femtoduino/femu-hardware/femu/femu-1.0.3.b_2-LAYER-BOTTOM.png

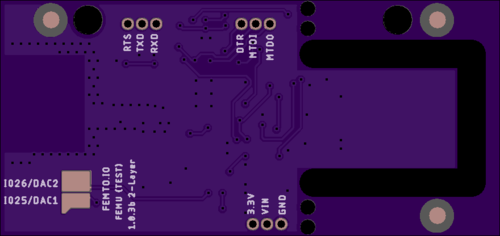
femu/femu-1.0.3.b_2-LAYER-BOTTOM.png
