femtoduino/femu-hardware/femu/femu-1.0.3.b_2-LAYER-TOP.png

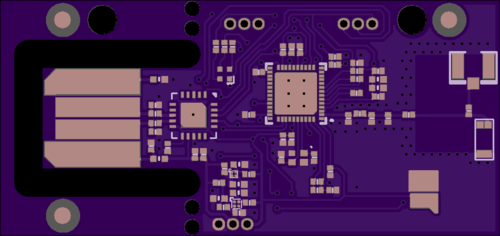
femu/femu-1.0.3.b_2-LAYER-TOP.png
