femtoduino/femu-hardware/femu/kicad/femu/femu-bottom.png

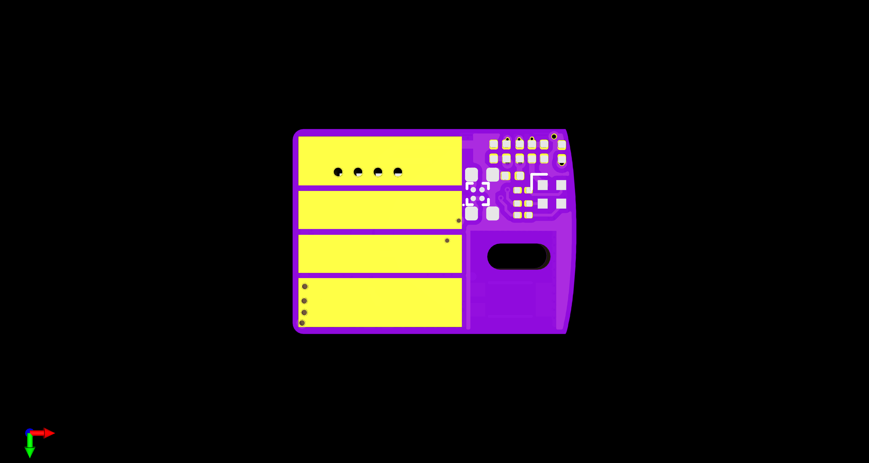
femu/kicad/femu/femu-bottom.png
