femtoduino/femu-hardware/3d-models/femu-2layer-wedge-Cube_001.stl

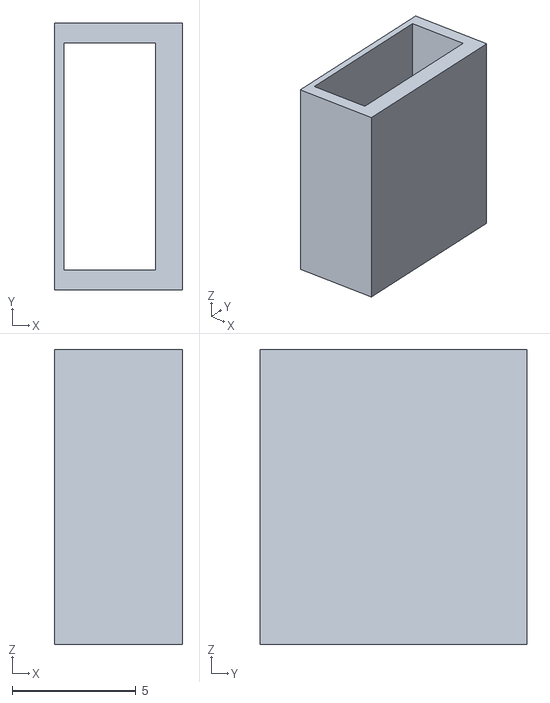
[picture p4: CAD file, 2019-12-23]
3d-models/femu-2layer-wedge-Cube_001.stl
5.20 x 10.8 x 11.9
