femtoduino/femu-hardware/3d-models/femu-2layer-1.0.3-jig-Cube.stl

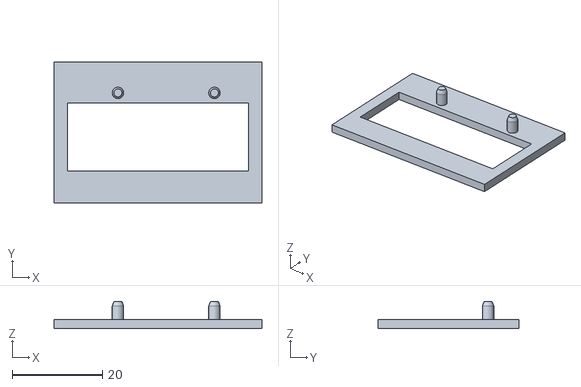
[picture p5: CAD file, 2019-12-23]
3d-models/femu-2layer-1.0.3-jig-Cube.stl
46.0 x 31.1 x 6.00
