femtoduino/femu-hardware/3d-models/femu-stencil-jig.stl

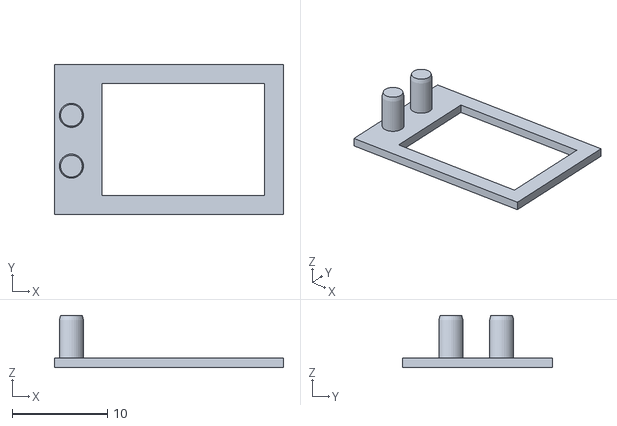
[picture p6: CAD file, 2019-08-23]
3d-models/femu-stencil-jig.stl
24.1 x 15.8 x 5.50
