femtoduino/femu-hardware/(list of files, cad)

Other CAD files:
3d-models/femu-2layer-1.0.3-jig.blend
3d-models/femu-2layer-wedge.blend
3d-models/femu-stencil-jig.blend
