femtoduino/femu-hardware/femu/femu-1.0.2-parts01005-schematic.pdf

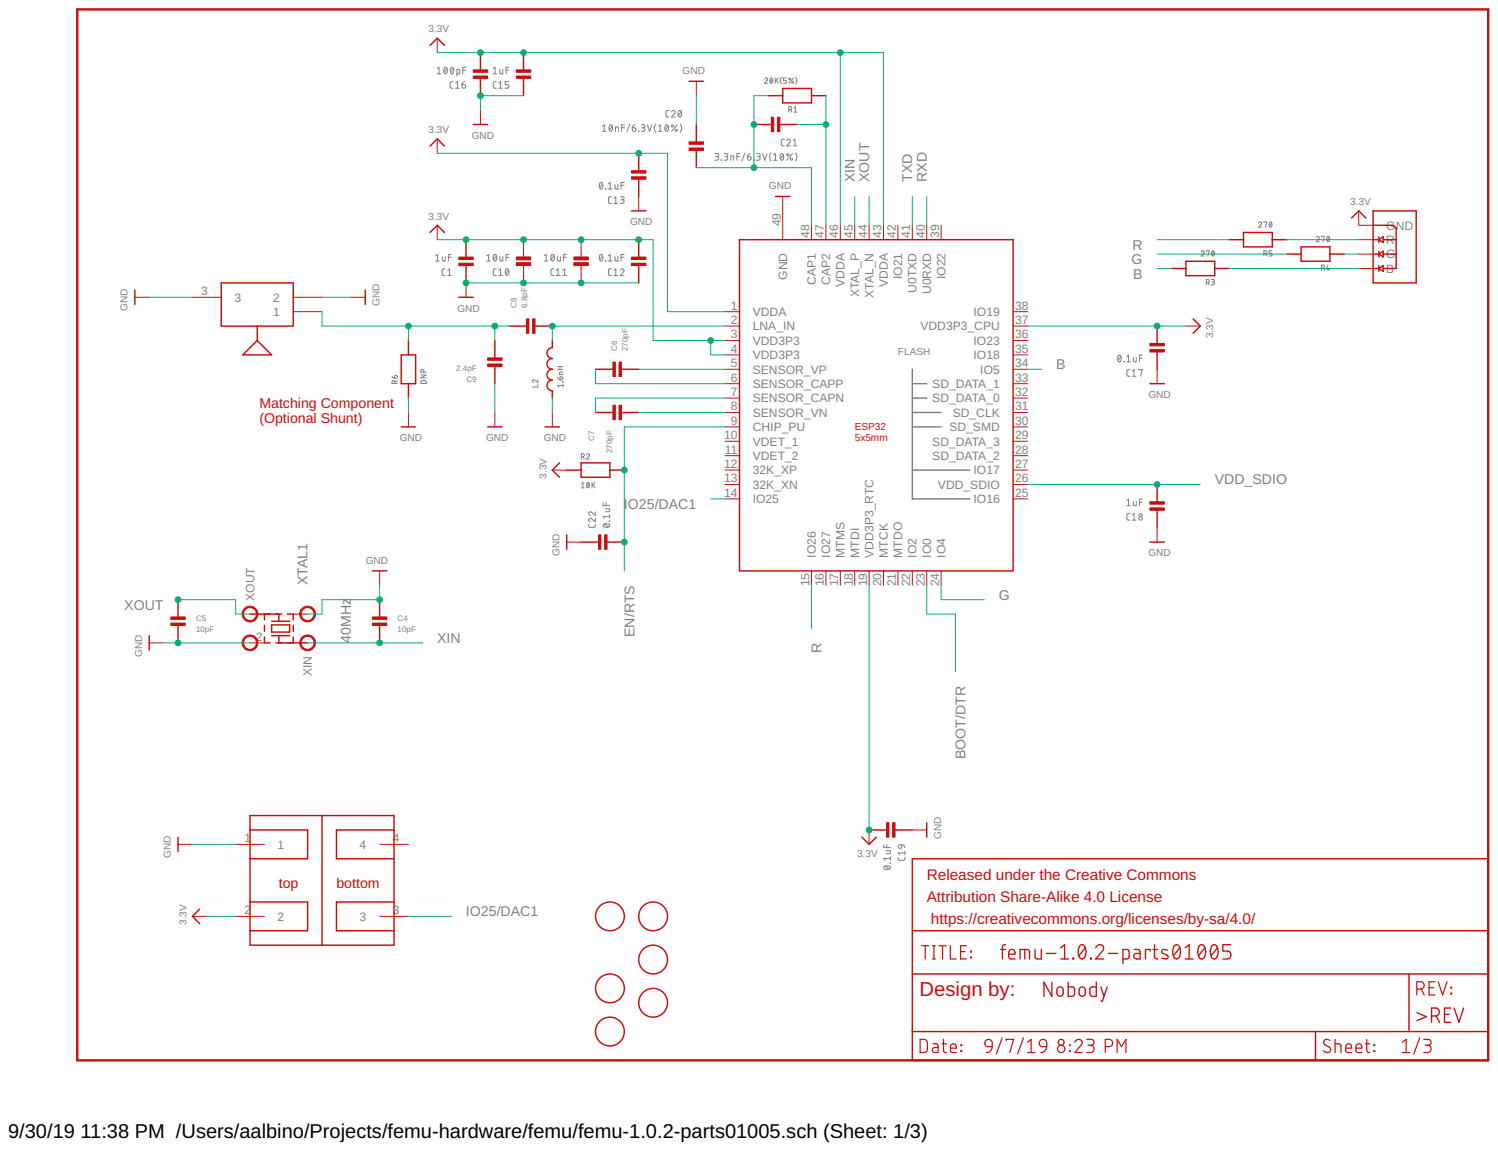
[picture p7: page 1]

Released under the Creative Commons Attribution Share-Alike 4.0 License

https://creativecommons.org/licenses/by-sa/4.0/

9/30/19 11:38 PM /Users/aalbino/Projects/femu-hardware/femu/femu-1.0.2-parts01005.sch (Sheet: 1/3)

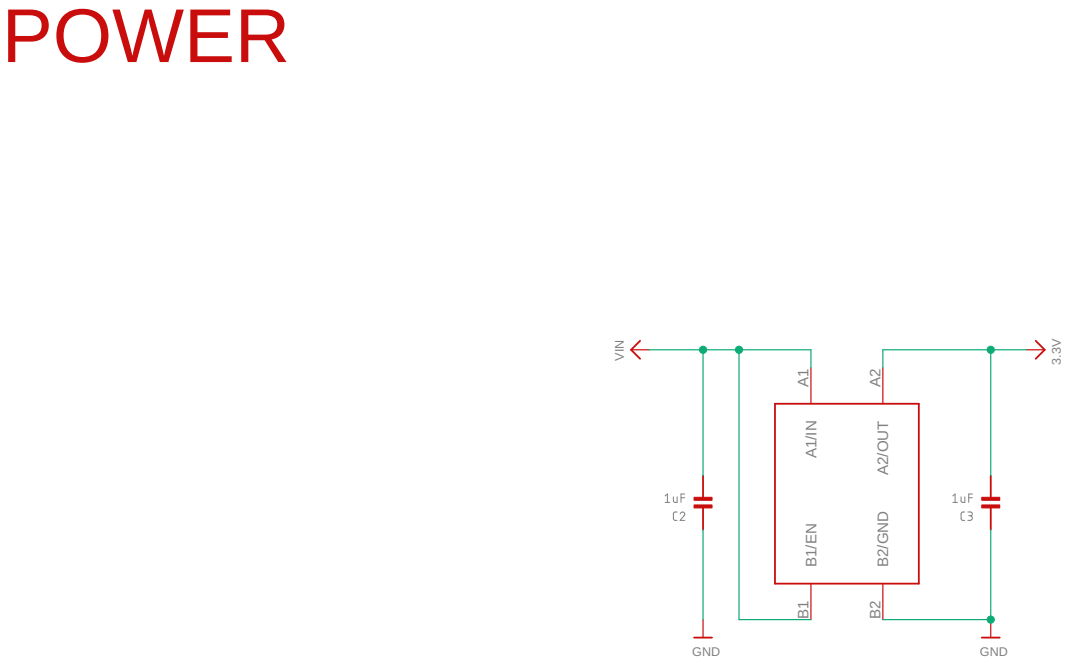
[picture p8: page 2]

Released under the Creative Commons Attribution Share-Alike 4.0 License

https://creativecommons.org/licenses/by-sa/4.0/

9/30/19 11:38 PM /Users/aalbino/Projects/femu-hardware/femu/femu-1.0.2-parts01005.sch (Sheet: 2/3)

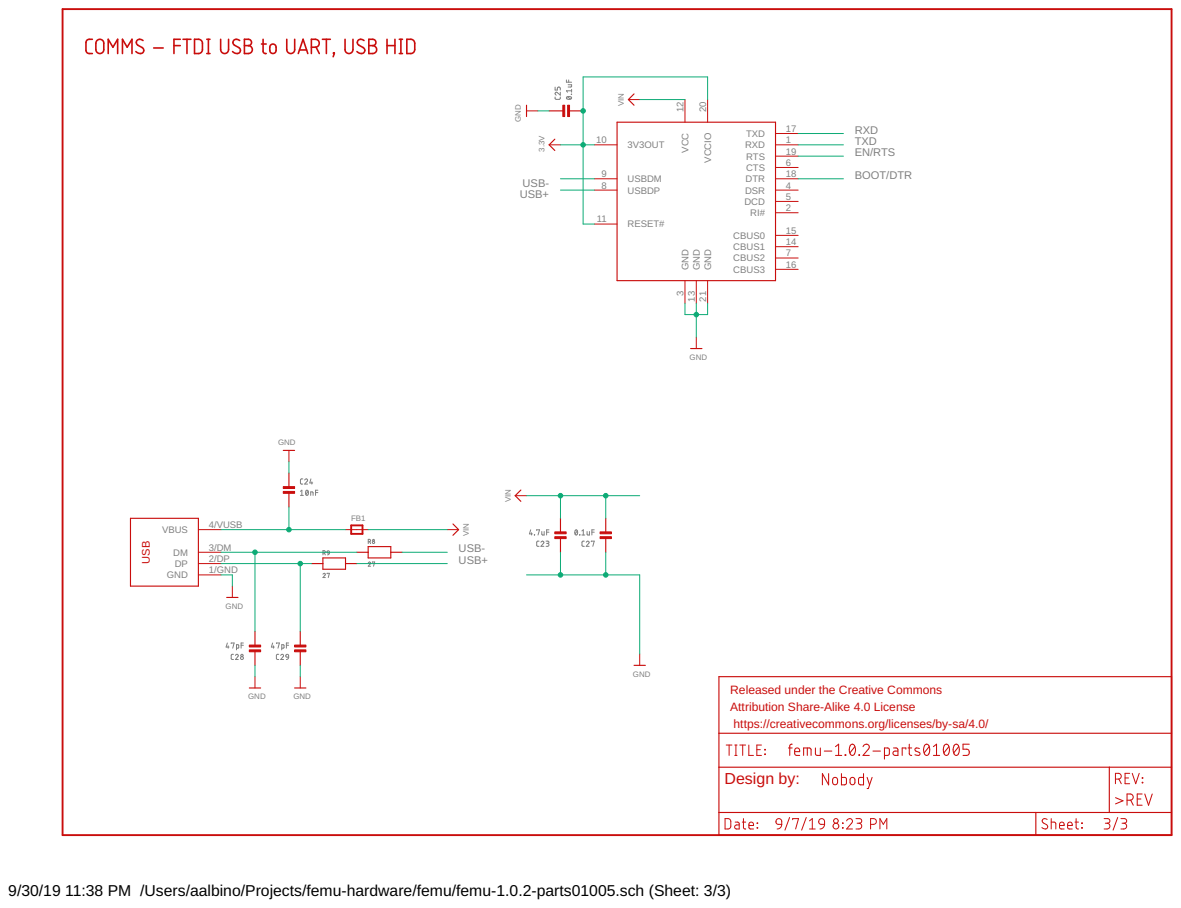
[picture p9: page 3]

Released under the Creative Commons Attribution Share-Alike 4.0 License

https://creativecommons.org/licenses/by-sa/4.0/

9/30/19 11:38 PM /Users/aalbino/Projects/femu-hardware/femu/femu-1.0.2-parts01005.sch (Sheet: 3/3)
