femtoduino/femu-hardware/(threads)

Thread 1 (2019-10-04):

How to produce this board

XenGi, 2019-10-04:
Ahoi,

I want to assemble this board but I can't find any documentation about it. I don't really care where to it (PCBWay, LSCPCB, etc) but I don't want to do it myself. I can do 0402 but I don't trust myself with anything smaller.
Can you guide me through the process? I tried to process it with PCBWay but have no clue how to operate eagle (KiCAD user) and I'm not sure what I should set in PCBWay for optimal results.

zrecore, 2019-10-04:
Ahoi, Ricardo! Which EAGLE brd file are you looking at?

- Alex Albino

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

XenGi, 2019-10-06:
I tried the `femu.brd` but I'm not sure which one I should use. Could you explain what they are for? There are 7 of them.

zrecore, 2019-10-06:
The FEMU design currently on GitHub is non functional. I am currently
resolving some design problems. As soon as I figure it out, ill let you
know.

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

XenGi, 2019-10-30:
Ahoi,
Any updates? Did you find some time to update the design?

XenGi, 2019-11-07:
Damn, can't imaging this going on around me. Hope you're ok.

zrecore, 2019-11-07:
Seems everything is back to normal. In any case, I have a test revision
(2-layer, larger) to test new components. In particular, I am testing the
existing LDO Regulator, and a new LDO regulator. Although FEMU r1.0.2 is
programable with 12pF XTAL caps, and Bluetooth operations work
intermittently when Serial output.is disabled, Wi-Fi does not currently
work. It scans for APs, but abruptly quits scanning, resulting in zero (0)
APs found. A few community members and I are currently tracking down the
cause (possibly power delivery related).

- Alex

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

neon12345, 2020-04-26:
Is the latest version now ready to use? And is "femu-1.0.3.brd" the right file, or one of the others?
