femtoduino/femu-hardware/(commit log)

2019-07-23 First revision of FEMU - Femto's ESP32 Micro USB
    [femu.bkcup.brd, femu.bkup.sch, femu.brd, femu.sch]
2019-07-23 Adding fiducials and stencil jig holes, adjusting dimension labels
    [femu.brd, femu.sch]
2019-07-25 Let's try the on semiconductor LDO. Might swap out with something else depending on community guidance regarding heat dissipation. Added edge connectors
    [femu.brd, femu.sch]
2019-07-27 Adding new 01005 parts library, and a femu board with 01005 sized passives near the edges to avoid milling issues during PCB fabrication. Removed tNames and tValues layer text of FB 1 in femu.brd. Ad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
    [femu-parts01005.brd, femu-parts01005.sch]
2019-07-27 Adjusting schematic to look nice
    [femu-parts01005.sch]
2019-07-27 Adjusting PCBWay_4_layer.cam to have milling as a drill file, moving some passives a bit to give FTDI chip some distance from passives, updating DRC settings .dru file to have tented vias
    [femu-parts01005.brd]
2019-07-27 Minor tweaks again
    [femu-parts01005.brd]
2019-07-30 Updating part names, and cleaning up + filling in MPN attributes
    [femu-parts01005.brd, femu-parts01005.csv, femu-parts01005.sch]
2019-07-30 XTAL should be using 10pF caps, not 8pF. Fixed
    [femu-parts01005.brd, femu-parts01005.sch]
2019-08-23 Updating BoM to use the FT231XQ
    [femu-1.0.1-parts01005-PANEL.brd, femu-1.0.1-parts01005.brd, femu-1.0.1-parts01005.csv, femu-1.0.1-parts01005.sch, femu-1.0.1-parts01005.xlsx, femu-pico-d4.brd, femu-pico-d4.sch, femu-stencil-jig.blend]
2019-08-23 Updating FTDI chip attribute
    [femu-1.0.1-parts01005.brd, femu-1.0.1-parts01005.sch]
2019-09-08 Fixed the RX/TX lines between FTDI chip and ESP32 chip. 🤦‍♂
    [femu-1.0.1-parts01005.xlsx, femu-1.0.2-parts01005.brd, femu-1.0.2-parts01005.sch]
2019-11-05 TEST femu 1.0.3b
    [femu-1.0.3.b_2-LAYER.brd, femu-1.0.3.b_2-LAYER.sch]
2019-11-08 FEMU test 1.0.3(c)
    [femu-1.0.3.c_2-LAYER.brd, femu-1.0.3.c_2-LAYER.sch]
2019-12-20 FEMU component test, 2-layer, revision 1.0.3.c - Seems to work
    [femu-1.0.3_2-LAYER.brd, femu-1.0.3_2-LAYER.sch]
2019-12-23 Adding work on femu 1.0.2, and 1.0.3
    [femu-1.0.0-ESP32-S2.brd, femu-1.0.0-ESP32-S2.sch, femu-1.0.2-parts01005.brd, femu-1.0.3.brd, femu-1.0.3.c_2-LAYER.brd, femu-1.0.3.c_2-LAYER.csv, femu-1.0.3.c_2-LAYER.sch, femu-1.0.3.sch]
2019-12-23 Adjusting MPNs for FEMU 1.0.3
    [femu-1.0.3.brd, femu-1.0.3.sch]
2020-05-08 Adding current work on FEMU v1.0.3, which includes microvia adjustments
    [femu-1.0.0-ESP32-S2.brd, femu-1.0.0-ESP32-S2.sch, femu-1.0.3.brd, femu-1.0.3.sch]
2020-07-29 Adding FEMU 1.0.4, with monopole antenna
    [femu-1.0.4.ty.brd, femu-1.0.4.ty.sch]
2020-07-29 last updates to femu-1.0.3 committed
    [femu-1.0.3.brd]
2020-07-29 Updating ground plane clearance, adding more ground plane vias, adjusting ground plane copper pour
    [femu-1.0.4.ty.brd, femu-1.0.4.ty.sch]
2020-07-29 Adjusted trace with of some RGB traces to 8mil, added more ground vias, connected ground pad under ESP32 using 5mil trace to other ground polygon area
    [femu-1.0.4.ty.brd]
2020-07-30 Removing junk ftdi config (empty file), updating taydo-yuden-rf-antenna library with an experimental footprint. Adjusting ground plane and antenna trace of femu-1.0.4.ty design
    [femu-1.0.4.ty.brd, femu-1.0.4.ty.sch]
2020-08-02 Adjusting RF matching components to improve waveguide and ground plane
    [femu-1.0.4.ty.01005.brd, femu-1.0.4.ty.01005.sch]
2020-08-02 femu 1.0.4, using 01005 components and W3008C antenna
    [femu-1.0.4.01005.brd, femu-1.0.4.01005.sch]
2020-08-02 Adjusting ty antenna variant with 01005 parts
    [femu-1.0.4.ty.01005.brd]
2020-08-02 Adjusting 3V3 line to clear ground plane under RF pin a bit more
    [femu-1.0.4.ty.01005.brd]
2020-08-06 Adjusting antenna and ground plane in femu-1.0.4.ty.01005 design. 11.35mil wide RF trace, 5mil isolation. At PCBWay 0.8mm thick PCB (0.175mm thick dialectric, constant 4.29)(copper thickness of 18um)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
    [femu-1.0.4.ty.01005.brd, femu-1.0.4.ty.01005.sch]
2020-08-06 Adjusting ground pours.
    [femu-1.0.4.ty.01005.brd, femu-1.0.4.ty.01005.sch]
2020-08-09 Adjusted trace width and distance for 35ohm impedance
    [femu-1.0.4.ty.01005.brd, femu-1.0.4.ty.01005.sch]
2020-08-12 Adding PulseLarsen W3008C variant of femu-1.0.4 (01005), in case the now EOL'd AH212M245001-T is unavailable
    [femu-1.0.4.pulse.01005.brd, femu-1.0.4.pulse.01005.sch]
2020-08-12 Adjusting femu-1.0.4.pulse.01005 design
    [femu-1.0.4.pulse.01005.brd]
2020-11-14 Current work on 1.0.4.ty.01005, and new 1.0.5.ty.01005 with increased distance between antenna and ground plane on the x-axis
    [femu-1.0.5.ty.01005.brd, femu-1.0.5.ty.01005.sch]
2021-01-04 Adding KiCAD redesign
    [femu.kicad_pcb, femu.sch]
2021-01-18 KiCAD design updates
    [femu.kicad_pcb, femu.kicad_sch, femu.sch]
2021-02-17 KiCAD femu gerber files
    [femu-B_Cu.gbl, femu-B_Mask.gbs, femu-B_Paste.gbp, femu-B_Silkscreen.gbo, femu-Edge_Cuts.gm1, femu-F_Cu.gtl, femu-F_Mask.gts, femu-F_Paste.gtp]
2021-02-17 Moving gerbers/drills into correct location
    [femu-B_Cu.gbl, femu-B_Mask.gbs, femu-B_Paste.gbp, femu-B_Silkscreen.gbo, femu-Edge_Cuts.gm1, femu-F_Cu.gtl, femu-F_Mask.gts, femu-F_Paste.gtp]
2021-02-17 Fixing git ignore rules
    [femu-NPTH.drl, femu-PTH.drl, femu-front-in1.drl, femu-front-in2.drl, femu-front-in3.drl, femu-front-in4.drl, femu-in2-in4.drl, femu-in3-back.drl]
2021-02-17 Saving changes to design fabrication settings stuff
    [femu.kicad_pcb]
2021-02-17 Adjusting VDD layer to have copper fill (3V3)
    [femu-B_Cu.gbl, femu-B_Mask.gbs, femu-B_Paste.gbp, femu-B_Silkscreen.gbo, femu-Edge_Cuts.gm1, femu-F_Cu.gtl, femu-F_Mask.gts, femu-F_Paste.gtp]
2021-03-12 Adjusting RF trace before matching components to be 35ohm impedance. Adjusting tiny RF trace after matching components to be 50ohm impedance
    [femu.kicad_pcb]
